azarkhish/smart-payphone/pics/takta/P1070384.JPG

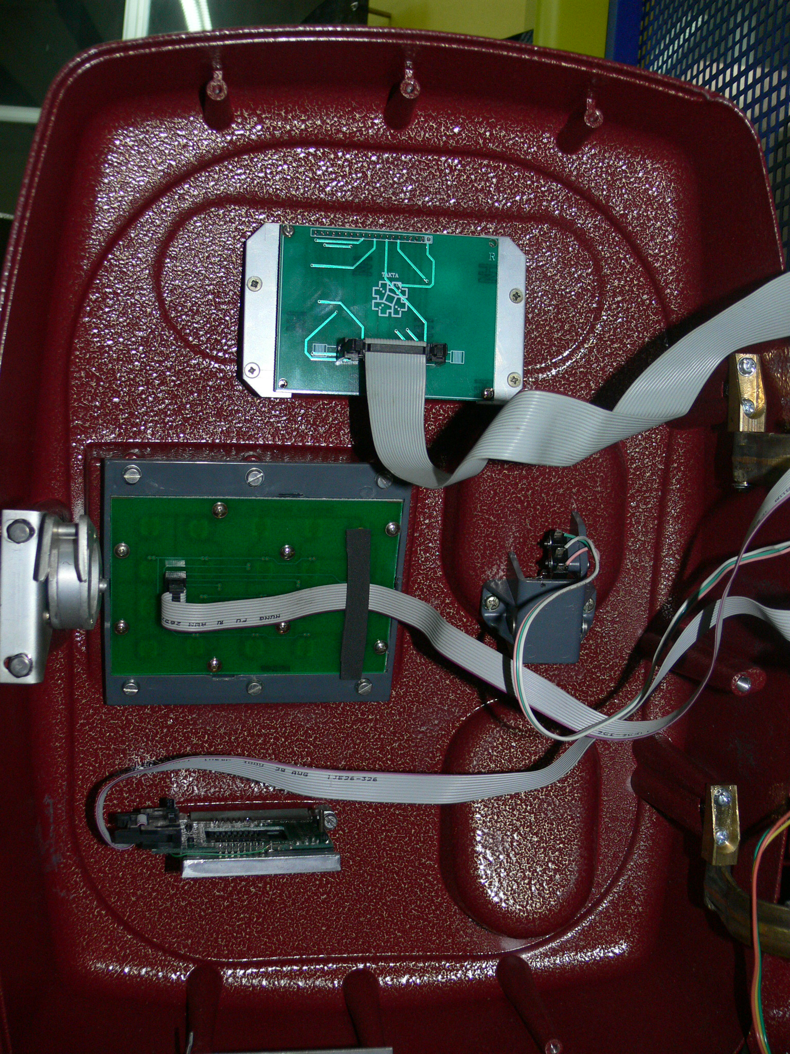
pics/takta/P1070384.JPG
