azarkhish/smart-payphone/pics/takta/P1070409.JPG

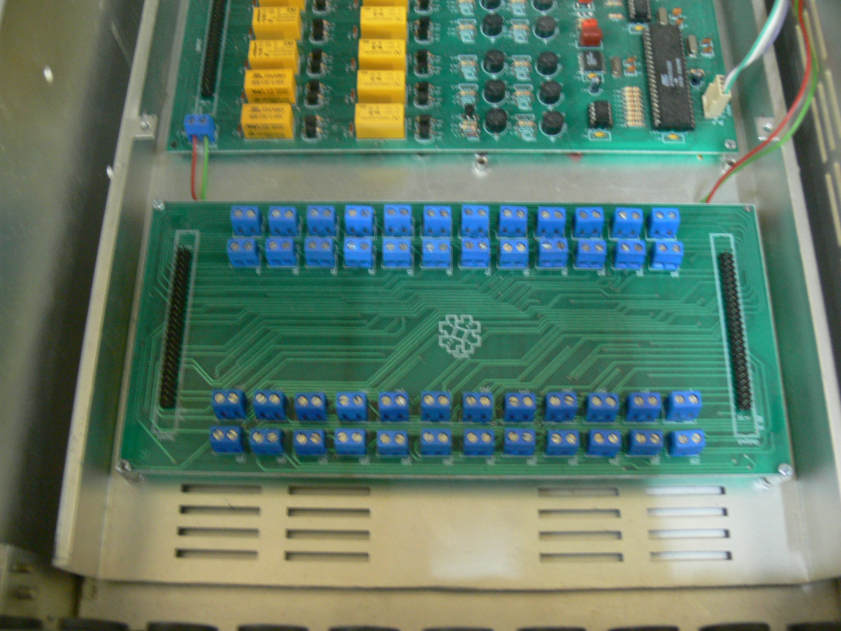
pics/takta/P1070409.JPG
