azarkhish/smart-payphone/info/antitap.pdf

بسمه تعالی

مشخصات فنی سيستم آنتی تپ فراموج آسيا 4001FAT

Out source adapter | تغذيه نوع
| ولتاژ تغذيه ورودی ١٢-٩ ولت DC
| تعداد خطوط ورودی ۴ خط
| جريان مصرفی دستگاه در حالت بی بار ١٠ mA
| بيشترين جريان مصرفی ١٠٠mA

روش استفاده:

-١ دستگاه را بر روی ديوار يا مکان مورد نظر نصب نماييد -٢ خطوط ورودی را به مکان مربوطه که در شکل ١ نمايش داده شده متصل کنيد -٣ خروجی هر مشترک را به خط ورودی متناظر آن وصل کنيد -۴ دستگاه آنتی تپ را توسط آداپتور مربوطه به برق شهری متصل کنيد -۵ پس از مدت ۵ ثانيه دستگاه در مود استاندارد قرار ميگيرد و قابل استفاده است -۶ در صورت استفاده بيش از يک دستگاه آنتی تپ برای تغذيه آن ميتوانيد از روش نمايش داده شده در شکل ٢ استفاده کنيد

تذکر: توجه داشته باشيد که هر دستگاه آنتی تپ قابليت پشتيبانی ۴ کانال(خط) را دارد و کانالها هيچ ارتباطی به هم ندارند بنابراين ميتوانيد از هرکدام از کانالهای موجود روی دستگاه به صورت اختياری استفاده کنيد و کانالهايی که استفاده نميشود را خالی بگذاريد

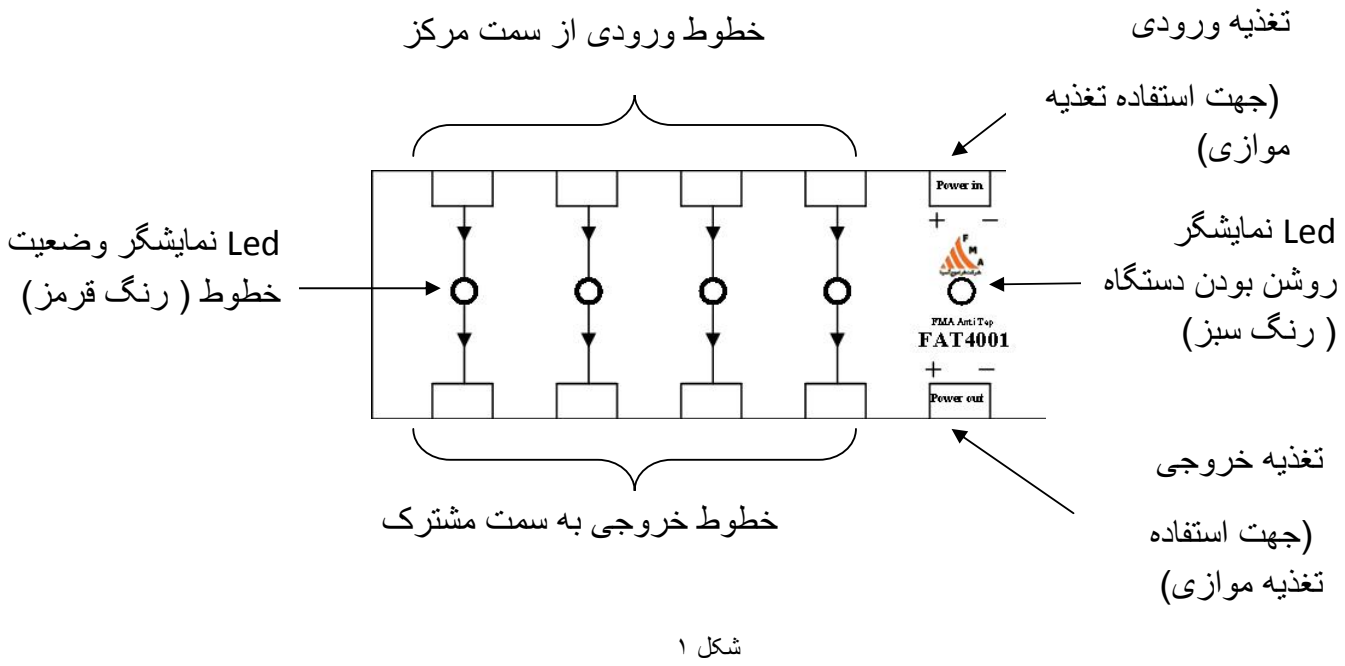
[picture p3: figure]
شکل ١; خطوط ورودی از سمت مرکز; خطوط خروجی به سمت مشترک; تغذيه ورودی; (جهت استفاده تغذيه موازی); تغذيه خروجی; Led نمايشگر روشن بودن دستگاه ( رنگ سبز); Led نمايشگر وضعيت خطوط ( رنگ قرمز)

روش استفاده از يک آداپتور برای تغذيه بيش از يک آنتی تپ

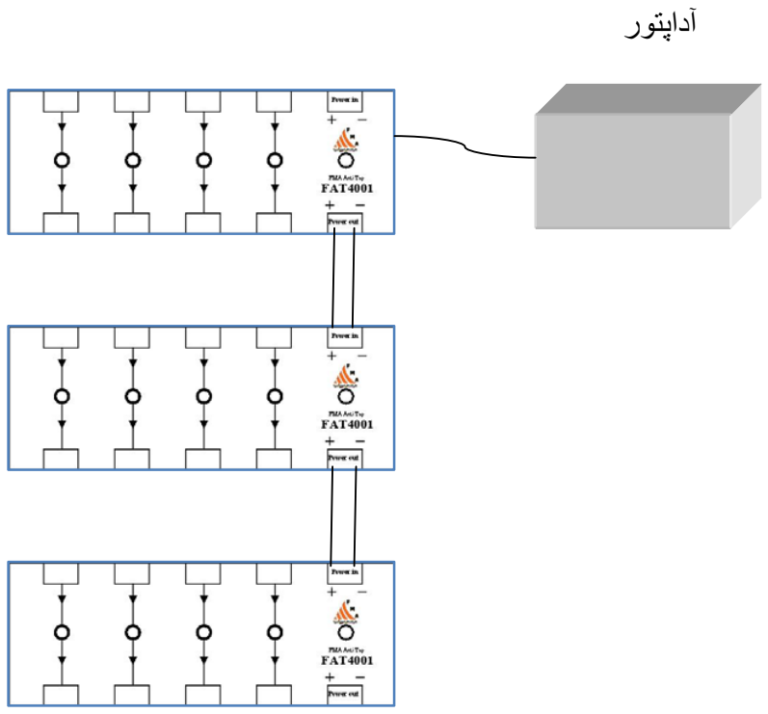
[picture p4: figure]
آداپتور

شکل ٢

توجه : با روش اتصال موازی حداکثر ميتوانيد ١٠ دستگاه را به هم متصل نماييد

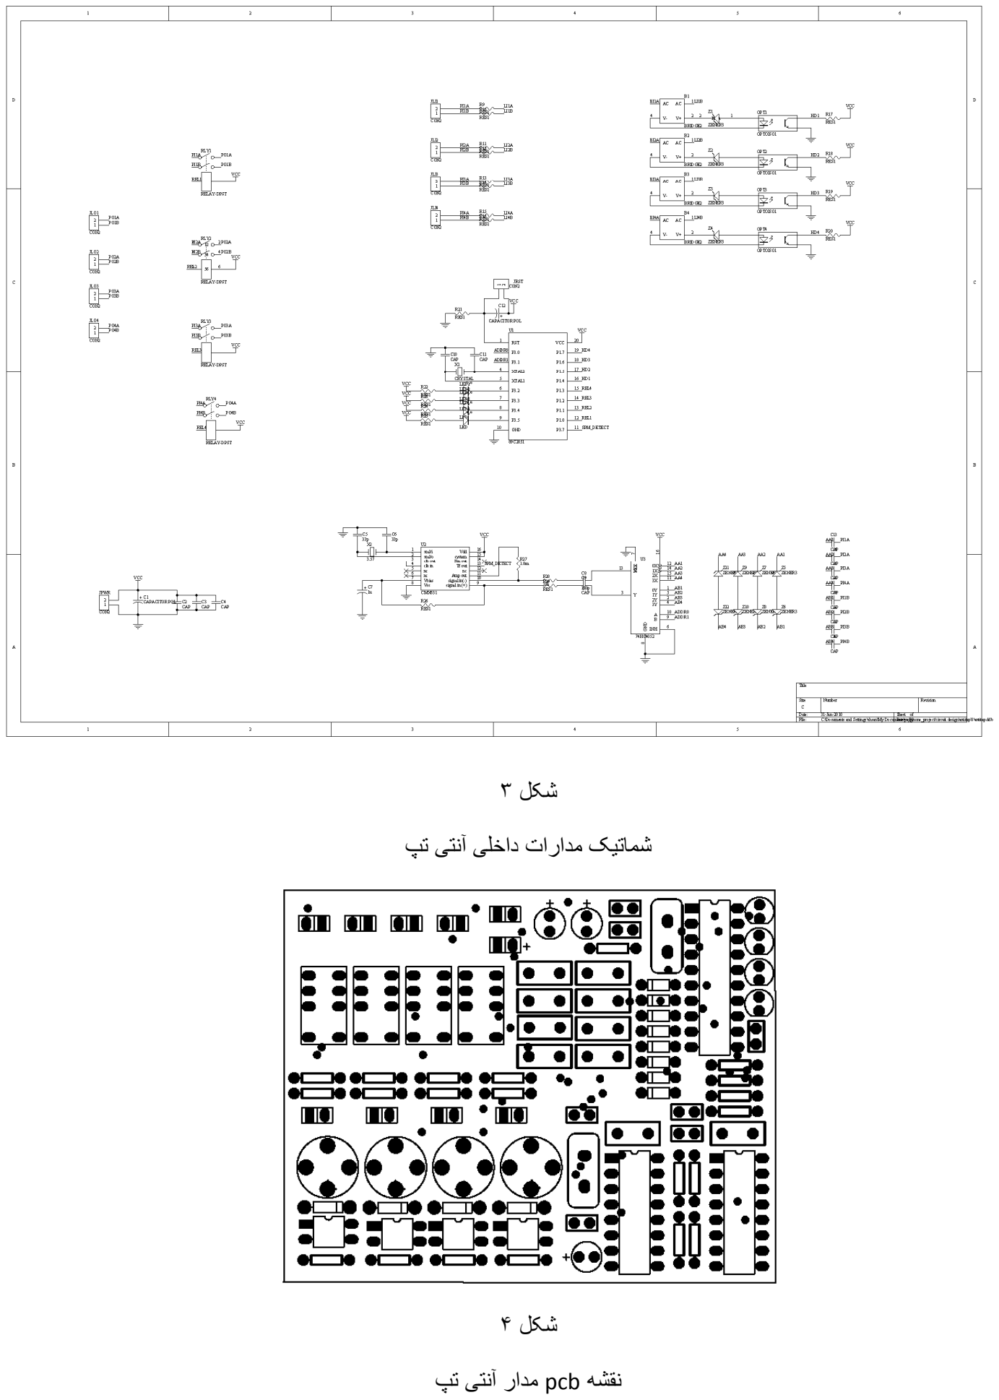
[picture p5: page 3]

شکل ٣

شماتيک مدارات داخلی آنتی تپ

شکل ۴

نقشه pcb مدار آنتی تپ
