azarkhish/smart-payphone/codes/PayPhone_ver_6/Picture/2.jpg

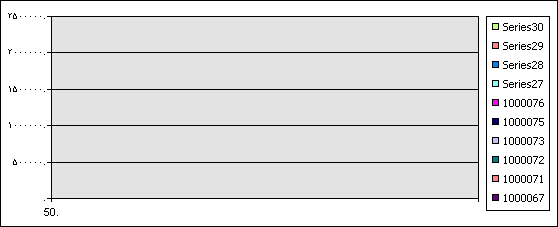
codes/PayPhone_ver_6/Picture/2.jpg
