azarkhish/smart-payphone/codes/PayPhone_ver_6/Picture/PMS/1.jpg

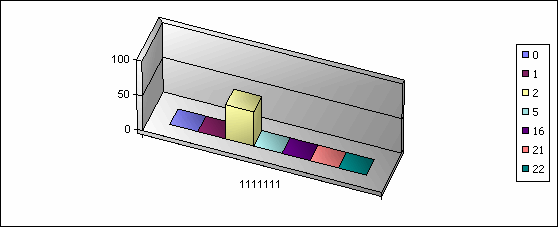
codes/PayPhone_ver_6/Picture/PMS/1.jpg
