azarkhish/smart-payphone/codes/PayPhone_ver_6/Picture/PMS/2.jpg

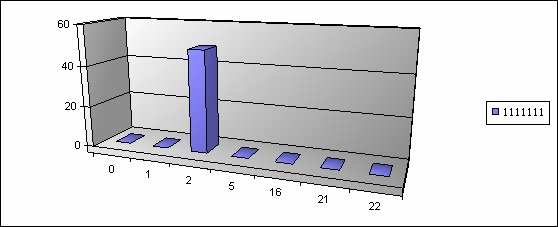
codes/PayPhone_ver_6/Picture/PMS/2.jpg
