azarkhish/smart-payphone/pics/circuits/DSC02536.JPG

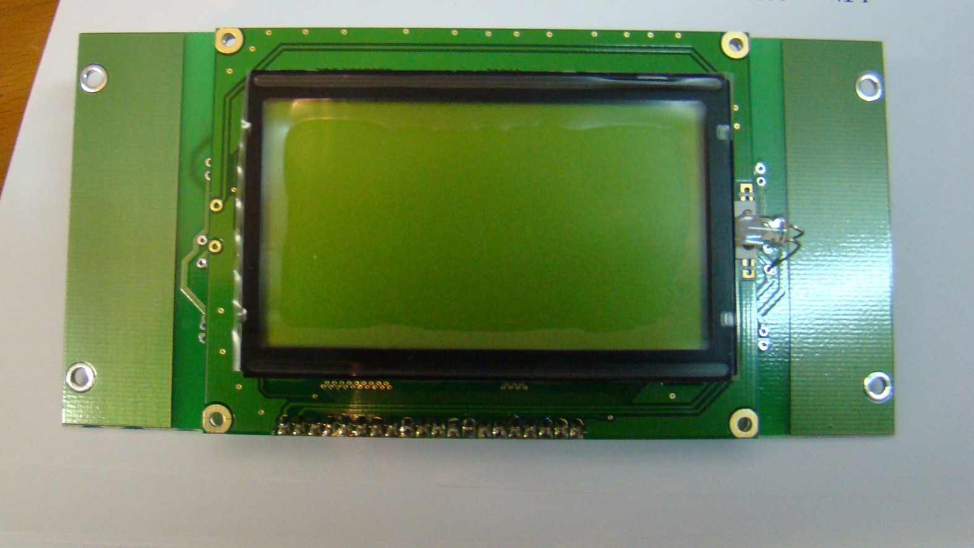
pics/circuits/DSC02536.JPG
