azarkhish/smart-payphone/pics/takta/P1070377.JPG

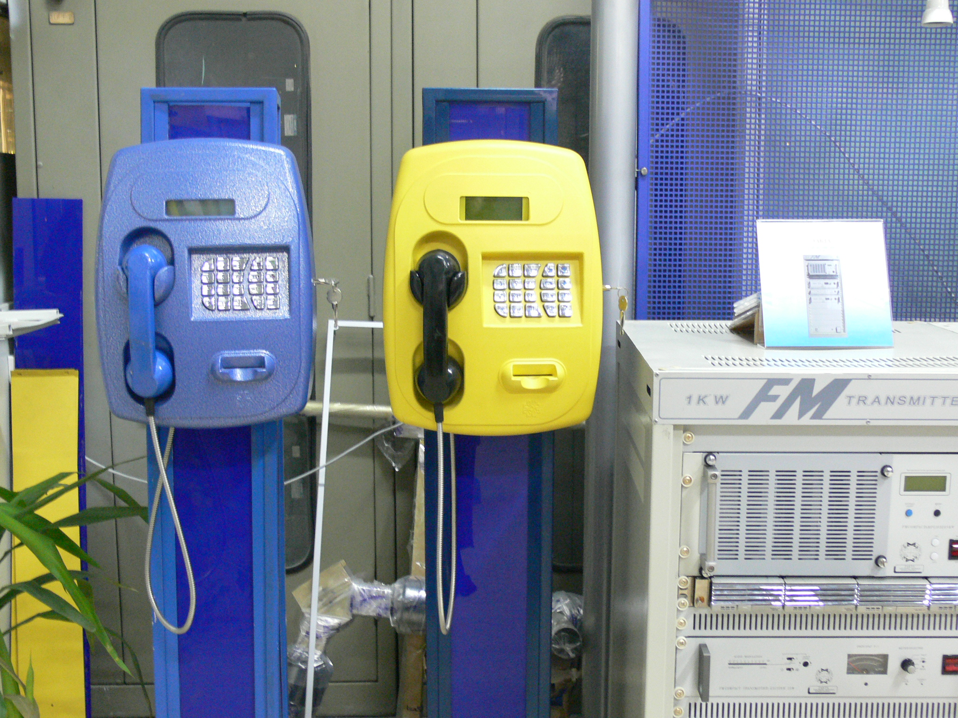
pics/takta/P1070377.JPG
