azarkhish/smart-payphone/pics/takta/P1070383.JPG

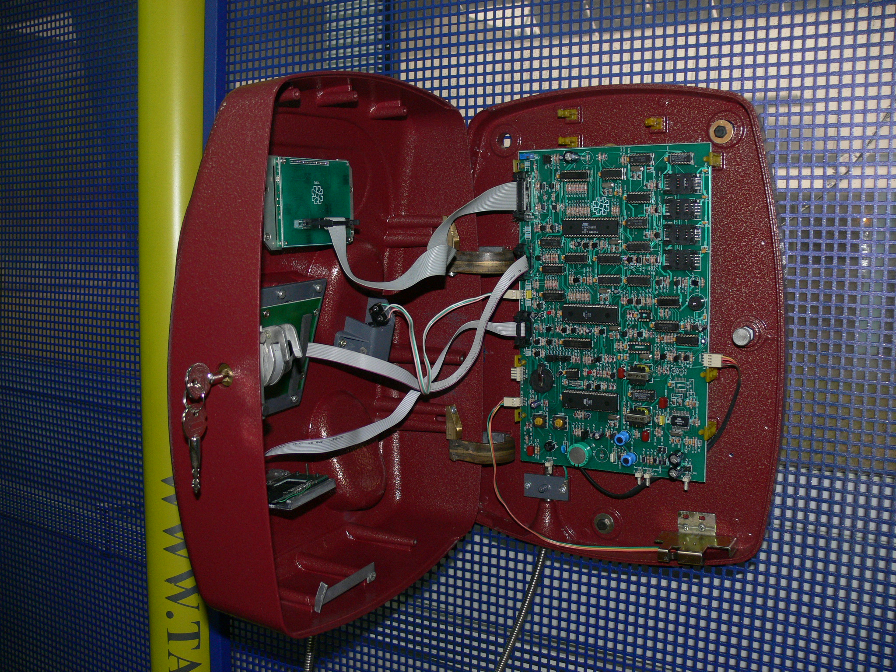
pics/takta/P1070383.JPG
