azarkhish/smart-payphone/pics/takta/P1070392.JPG

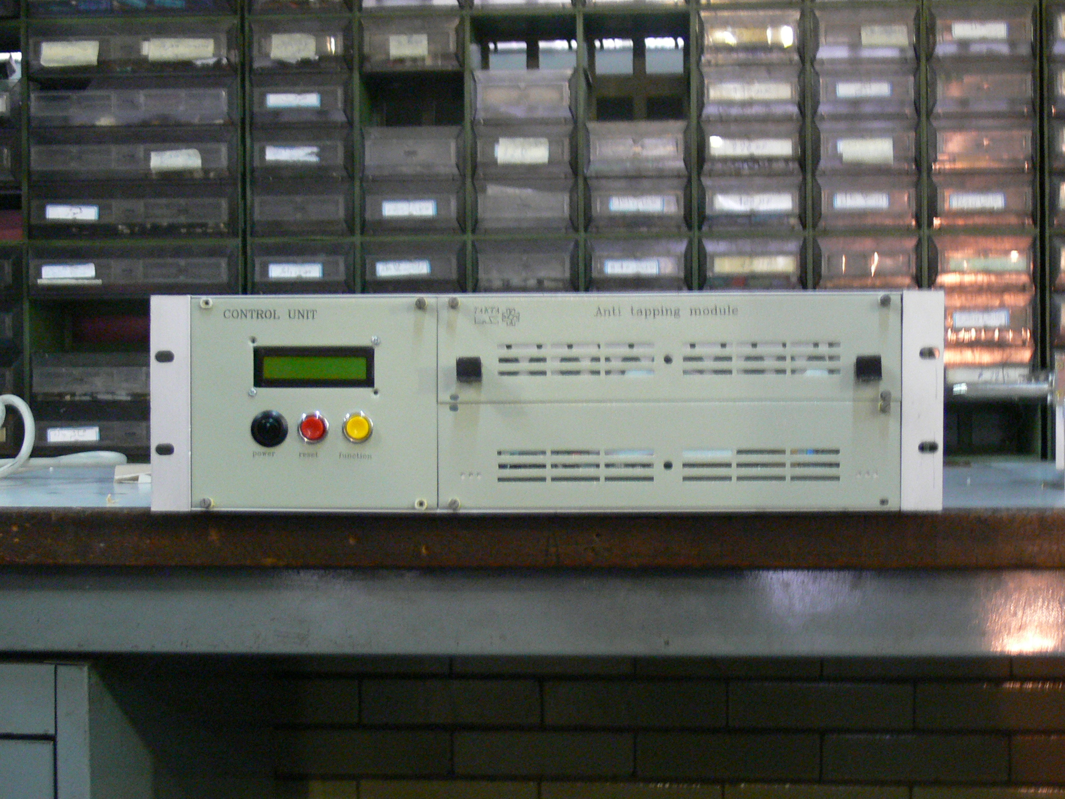
pics/takta/P1070392.JPG
