azarkhish/smart-payphone/pics/takta/P1070412.JPG

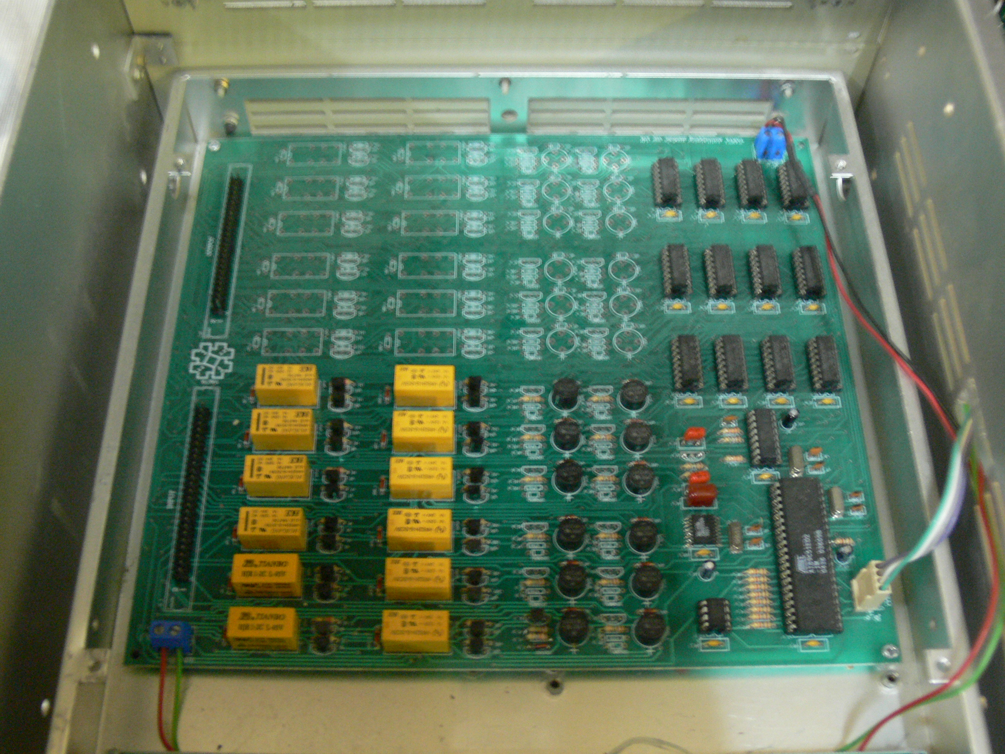
pics/takta/P1070412.JPG
