azarkhish/smart-payphone/pics/takta/P1070416.JPG

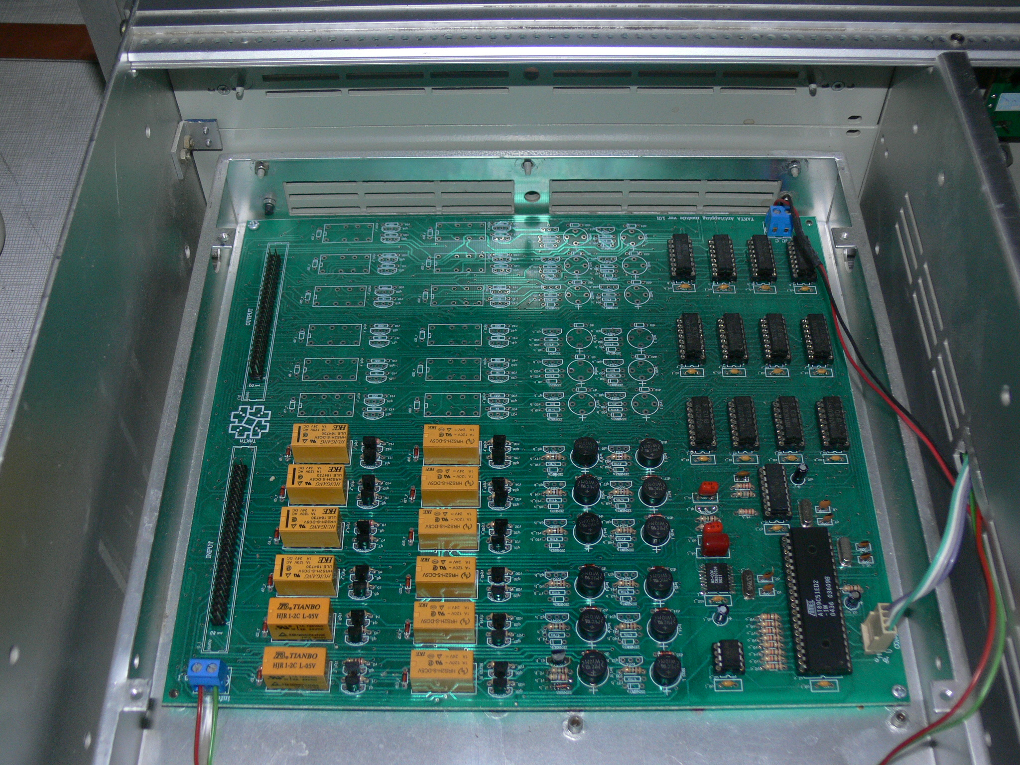
pics/takta/P1070416.JPG
