azarkhish/smart-payphone/pics/takta/P1070417.JPG

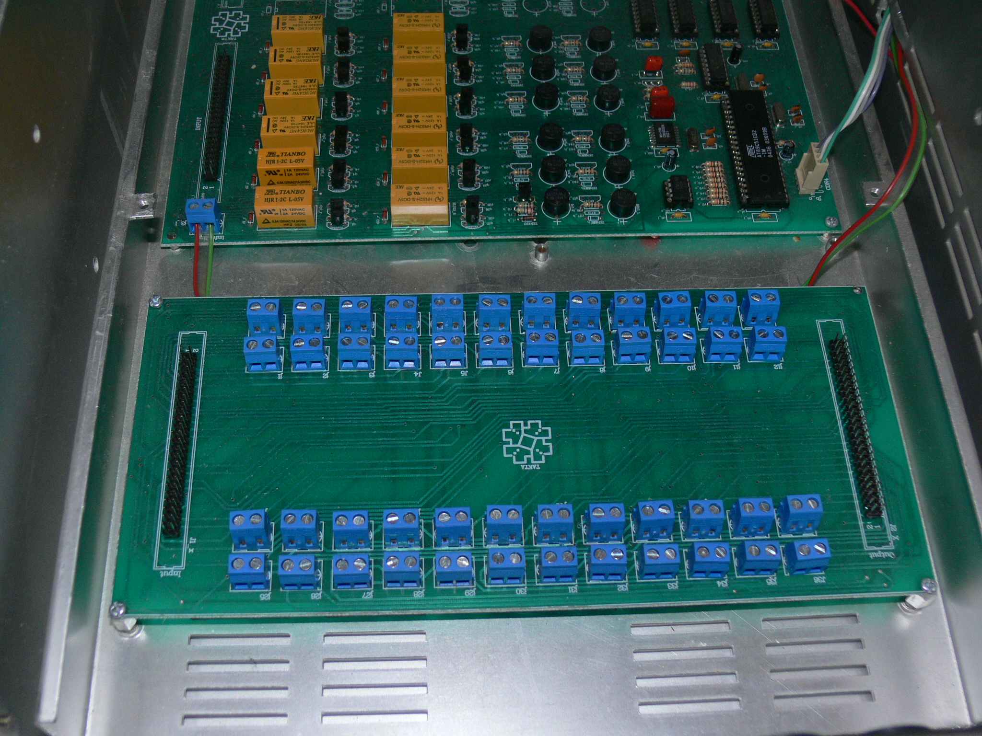
pics/takta/P1070417.JPG
