azarkhish/smart-payphone/pics/takta/P1070419.JPG

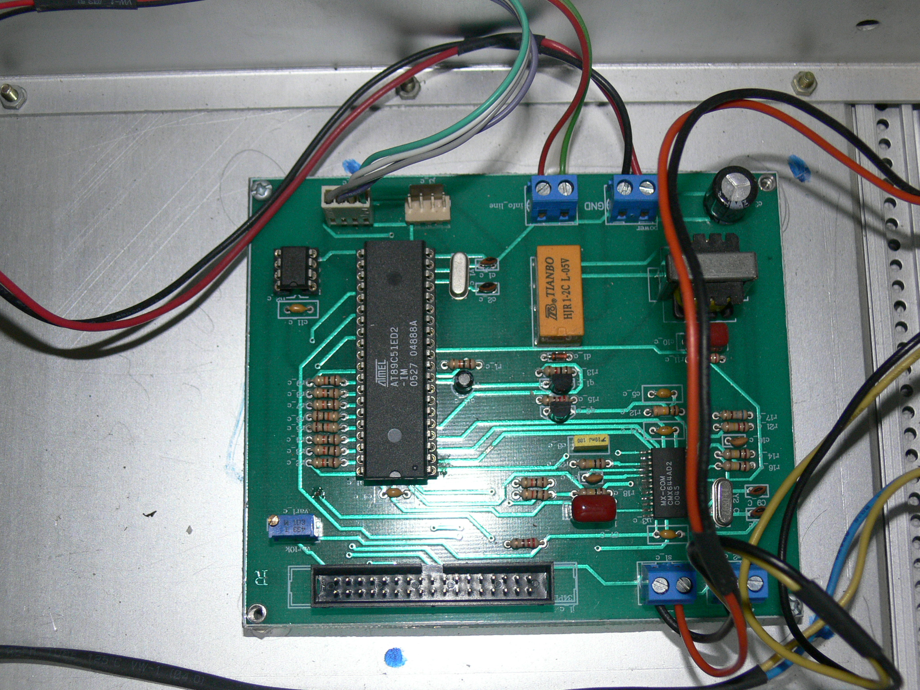
pics/takta/P1070419.JPG
