azarkhish/smart-payphone/bom/mainboard_bom.xls

Comment | اندازه | نوع قطعه | Quantity | Designators
Lithium 3v |  | Battery | 1 | bt1_r
جا باطری سکه ای |  | Battery Holder | 1
mpsa42 |  | BJT Transistor | 15 | q9_p | q2_k | q1_k | q6_p | q6_d | q5_s | q5_p | q4_v | q4_p | q4_d | q3_p | q3_d | q2_v | q1_c | q8_a
mpsa92 |  | BJT Transistor | 10 | q7_a | q5_d | q4_s | q3_v | q3_s | q2_s | q2_d | q1_s | q8_d | q10_p
bc308 |  | BJT Transistor | 2 | q1_v | q1_p
c547b |  | BJT Transistor | 3 | q2_p | q1_d | q11_p
32khz |  | Clock Crystal | 1 | y1_r
2n7002 cmos n-channel transsistor |  | Cmos Transistor | 4 | q8_p | q6_a | q4_a | q1_a
bss84 cmos p-channel transistor |  | Cmos Transistor | 4 | q7_p | q5_a | q3_a | q2_a
کانکتور مخابراتی 3 پین(مربعی) |  | Connector | 2 | j1_d
کانکتور مخابراتی 4 پین(مربعی) |  | Connector | 1 | j1_v
کانکتور مخابراتی 2 پین(مربعی) |  | Connector | 2 | j2_v
ترمینال 2 پین پیچ دار |  | Connector | 1 | j1_p
3.57 Mhz |  | Crystal | 3 | y1_sp | y1_s | y1_at
11.05Mhz small |  | Crystal | 1 | y1_mod
12Mhz small |  | Crystal | 1 | y1_t
1n4148 |  | Diode | 19 | d8_d | d7_d | d5_d | d4_p | d4_d | d3_r | d3_p | d3_d | d2_v | d2_r | d2_p | d2_d | d1_v | d1_r | d1_p | d1_l | d1_d | d1_c | d9_d
capasitor 0.1F 5v NEC-Tokin |  | electrolite Capacitor | 2 | c7_p | c6_p
0.22u 16v electrolite |  | electrolite Capacitor | 2 | c5_v | c1_r
100u 16v electrolite |  | electrolite Capacitor | 6 | c12_p | c9_p | c8_v | c4_a | c2_d | c1_a
10u 16v electrolite |  | electrolite Capacitor | 7 | c11_p | c5_p | c4_d | c3_t | c3_a | c2_v | c2_a
1u 16v electrolite |  | electrolite Capacitor | 3 | c5_sp | c3_sp | c2_r
24c512 |  | IC | 2 | u2_e2p | u1_e2p
74HC04 |  | IC | 1 | u1_s
74HC4051 |  | IC | 1 | u2_v
74HC4052 |  | IC | 5 | u4_t | u3_t | u3_s | u2_t | u2_s
CD4016B |  | IC | 2 | u2_k | u1_k
CMX605 |  | IC | 1 | u1_at
CMX631 |  | IC | 1 | u1_sp
CMX644 |  | IC | 1 | u1_mod
89c51ED2 |  | IC | 1 | u1_t
LM324 |  | IC | 1 | u1_v
PCF8593 |  | IC | 1 | u1_r
کانکتور plcc 44 پین SMD |  | IC Socket
0.22u 60v MKT |  | MKT Capacitor | 1 | c4_at
1u 100v MKT |  | MKT Capacitor | 7 | c13_p | c12_v | c10_v | c10_mod | c7_v | c7_mod | c3_at
100n |  | multilayer cap | 26 | c6_at | c17_v | c16_v | c14_s | c13_s | c12_s | c11_s | c10_s | c10_p | c9_s | c9_mod | c8_s | c8_p | c7_t | c6_t | c5_t | c5_mod | c5_at | c4_t | c4_sp | c3_mod | c3_d | c2_k | c2_e2p | c1_k | c1_e2p
PHL 2*5 نری و مادگی |  | PHL Connector | 2 | j1_c
PHL 2*10 نری و مادگی |  | PHL Connector | 1 | j1_l
jumper 2پین |  | Pin Header | 3 | cb2_d | cb1_d | cb1_a
10n polysteren |  | Polysteren Capacitor | 4 | c4_p | c3_p | c2_p | c1_p
سوییچ فشاری کوچک |  | Push Switch | 2 | s2_p
پل دیودی گرد کوچک |  | Rectifier Bridge | 1 | br1_p
S81250 regulator 5v |  | Regulator | 1 | u2_p
LP2980 regulator 3.3v |  | Regulator | 1 | u1_p
1.8m |  | Resistor 0.25W | 1 | r1_sp
100k |  | Resistor 0.25W | 19 | r12_p | r12_a | r10_v | r10_s | r9_s | r9_mod | r8_v | r8_s | r7_s | r6_a | r5_p | r5_mod | r3_mod | r2_mod | r2_k | r1_k | r1_a | r14_d | r18_p
10k |  | Resistor 0.25W | 15 | r15_v | r7_mod | r6_v | r4_r | r3_r | r7_k | r3_d | r2_t | r2_e2p | r2_d | r1_r | r1_l | r1_e2p | r15_d | r7_d
120k |  | Resistor 0.25W | 1 | r8_mod
150k |  | Resistor 0.25W | 1 | r1_mod
1k |  | Resistor 0.25W | 7 | r6_k | r5_k | r4_k | r3_k | r3_v | r1_v | r16_p
1m |  | Resistor 0.25W | 9 | r13_p | r13_a | r12_d | r11_p | r7_a | r5_d | r2_s | r2_a | r1_d
2.2k |  | Resistor 0.25W | 4 | r14_a | r11_v | r9_a | r3_s
2.2m |  | Resistor 0.25W | 3 | r10_d | r6_d | r4_d
22 ohm |  | Resistor 0.25W | 6 | r11_a | r9_p | r8_a | r4_a | r3_a | r2_sp
220 ohm |  | Resistor 0.25W | 1 | r2_r
22k |  | Resistor 0.25W | 13 | r18_s | r17_s | r16_s | r15_s | r9_v | r8_p | r7_p | r6_s | r5_s | r4_v | r4_s | r1_s | r1_c
3.3k |  | Resistor 0.25W | 1 | r12_v
330k |  | Resistor 0.25W | 5 | r15_p | r10_p | r10_a | r2_p | r16_d
33k |  | Resistor 0.25W | 3 | r6_p | r3_sp | r2_v
390 ohm |  | Resistor 0.25W | 1 | r3_p
4.7k |  | Resistor 0.25W | 12 | r17_v | r16_v | r14_s | r13_v | r13_s | r12_s | r11_s | r5_v | r4_p | r3_t | r15_a | r17_d
47k |  | Resistor 0.25W | 4 | r19_s | r13_d | r2_c | r1_p
5.6k |  | Resistor 0.25W | 1 | r14_v
560k |  | Resistor 0.25W | 2 | r11_d | r7_v
600 ohm |  | Resistor 0.25W | 1 | r4_mod
82k |  | Resistor 0.25W | 1 | r6_mod
arrey 8*10k |  | Ressistor Arrey
کانکتور سیم کارت |  | SAM Connector | 4 | j1_s
transformer choke 1:1 600 ohm |  | Transformer | 1 | a1_mod
Varistor 250v |  | Varistor 5mm | 1 | var1_p
c5v |  | Zenner Diode | 2 | z1_l | z1_d
c8.2v |  | Zenner Diode | 1 | z1_p
100p |  | عدسی 3mm | 1 | c3_s
10n عدسی |  | عدسی 3mm | 2 | c11_v | c8_mod
150p عدسی |  | عدسی 3mm | 1 | c6_sp
1n عدسی |  | عدسی 3mm | 5 | c14_v | c13_v | c9_v | c4_v | c1_v
220p عدسی |  | عدسی 3mm | 2 | c6_v | c3_v
22p عدسی |  | عدسی 3mm | 1 | c3_r
330p |  | عدسی 3mm | 2 | c6_mod | c4_mod
33p |  | عدسی 3mm | 15 | c7_s | c6_s | c5_s | c4_s | c2_t | c2_sp | c2_s | c2_mod | c2_at | c1_t | c1_sp | c1_s | c1_mod | c1_c | c1_at
470p |  | عدسی 3mm | 1 | c1_d
IC Socket 8 pin |  | IC Socket نظامی | 3
IC Socket 14 pin |  | IC Socket نظامی | 4
IC Socket 16 pin |  | IC Socket نظامی | 7
