azarkhish/smart-payphone/(list of files, cad)

Other CAD files:
codes/micro controllers/antitap/Ver3-4/at_source.OBJ
codes/micro controllers/antitap/Ver3-5/STARTUP.OBJ
codes/micro controllers/antitap/ver3_3/STARTUP.OBJ
codes/micro controllers/antitap/ver3_3/test/STARTUP.OBJ
codes/micro controllers/card reader/1_no_comport/Tel.OBJ
codes/micro controllers/card reader/2_com_test/Tel.OBJ
codes/micro controllers/card reader/3_com_final/Tel.OBJ
codes/micro controllers/card reader/4_pc_to_card_e2p/Tel.OBJ
codes/micro controllers/card reader/5_pc_to_reader_e2p/Tel.OBJ
codes/micro controllers/card reader/6_micro_upgrade/Tel.OBJ
codes/micro controllers/card reader/micro_upgrade/Tel.OBJ
codes/micro controllers/tel micro/tel_u_works/defrag_boot_loader_3/Tel.OBJ
codes/micro controllers/tel micro/tel_u_works/for antitap test/Tel.OBJ
codes/micro controllers/tel micro/tel_u_works/pulse dial problem/1_50%/Tel.OBJ
codes/micro controllers/tel micro/tel_u_works/pulse dial problem/2_33%/Tel.OBJ
codes/micro controllers/tel micro/tel_u_works/pulse dial problem/3_40%/Tel.OBJ
codes/micro controllers/tel micro/tel_u_works/tel_u_refrence/Tel.OBJ
codes/micro controllers/tel micro/tel_u_works/tel_u_test_semnan/Tel.OBJ
codes/micro controllers/tel micro/tel_u_works/tel_u_ver2_sam/Tel.OBJ
codes/micro controllers/tel micro/tel_u_works/tel_u_ver6/Tel.OBJ
codes/micro controllers/tel micro/tel_u_works/tel_u_ver_edit/Tel.OBJ
codes/micro controllers/test micro/test u/Tel.OBJ
codes/micro controllers/antitap/Ver3-4/STARTUP.OBJ
codes/micro controllers/antitap/Ver3-5/at_source.OBJ
codes/micro controllers/antitap/ver3_1/lock.OBJ
codes/micro controllers/antitap/ver3_2/STARTUP.OBJ
codes/micro controllers/tel micro/tel_u_works/tel_u_ver2/Tel.OBJ
codes/micro controllers/tel micro/tel_u_works/tel_u_ver3/Tel.OBJ
codes/micro controllers/tel micro/tel_u_works/tel_u_ver4/Tel.OBJ
codes/micro controllers/tel micro/tel_u_works/tel_u_ver5/Tel.OBJ
