azarkhish/smart-payphone/(list of files, drawings)

Other design files:
circuits/antitap/PCB1.PCB
circuits/antitap/Previous Backup of PCB1.PCB
circuits/card reader/Backup of mtread.pcb
circuits/card reader/mtread.pcb
circuits/card reader/Previous Backup of mtread.pcb
circuits/lcd/lcd.Pcb
circuits/maintenance card/card.pcb
circuits/protection/protection.pcb
